brianthornock/Percussor/README.md

# Percussor
A Digitally-Controlled Analog Kick Drum Machine
