brianthornock/Percussor/Percussor_FullSchematic.png

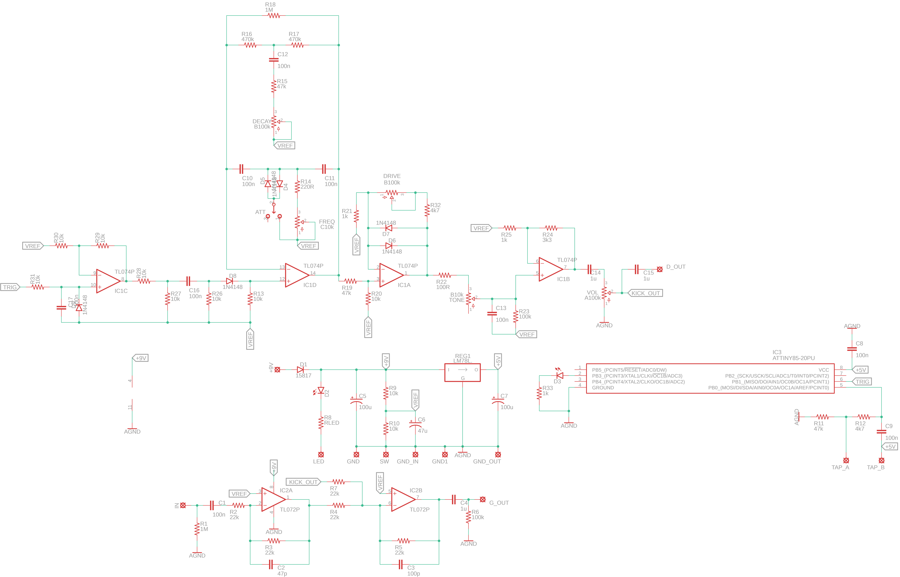
Percussor_FullSchematic.png
