brianthornock/Percussor/Percussor_Build_Documentation.pdf

# Percussor

## Digitally Controlled Analog Kick Drum with Tap Tempo

Provided to the DIY community for non-commercial use by Brian Thornock, copyright 2023

Overview

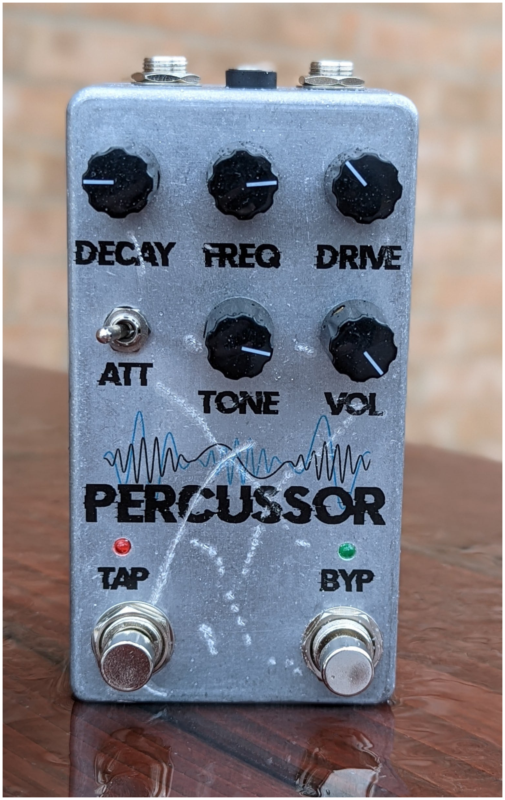
[picture p2: figure]

Have you ever seen one of those one man band performers with the bass drum on their back? It's kind of cool with how the bass drum helps keep the beat and can really flesh out a solo performance. If you have something that will do it for you, it also helps keep time and sounds way cooler than a boring metronome click. So I started looking around at analog kick drum circuits and found one that had some great sound shaping capability and decided I had to make a tap tempo kick drum pedal.

How it Works

The concept for the Percussor pretty straightforward. It has three main parts: guitar audio path, trigger generation, and the kick drum circuit. The guitar audio path allows for the kick drum sound to be mixed in with the guitar signal so that you can send it all to an amplifier and play it together. It also has the ability to send the kick drum signal out on it's own, acting as a standalone kick drum generator if you want to send it to its own channel or something like that. As you can see below, the guitar audio path is simply an inverting input buffer and a summing amplifier, so that overall the output is in phase with the input.

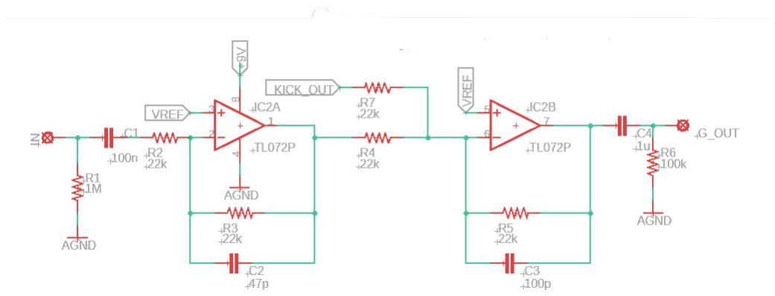
[picture p3: figure]

Percussor Guitar Audio Path

The kick drum circuit actually isn't mine, I found it third hand on a blog post linked on my website. It's a pretty clever design and only uses a single TL074 quad opamp package to provide controls for frequency, decay, drive, and tone, along with a two position attach switch. I did need to convert it to single supply voltage and I made a few small adjustments to taste, but it's certainly not an original design on my part.

The first opamp is used for conditioning the input pulse so that it will work well with the following stage.

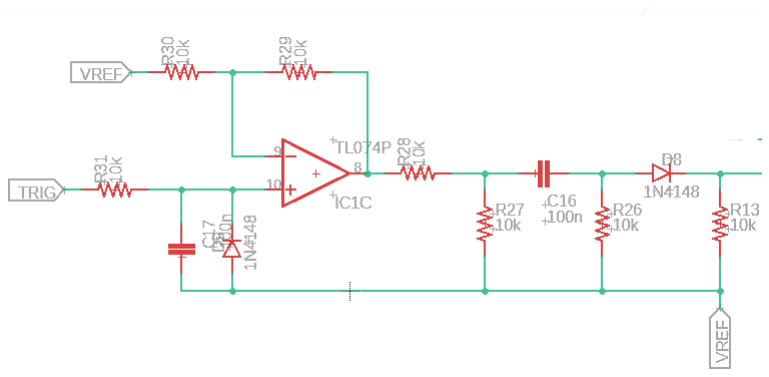
[picture p4: figure]

Percussor Pulse Conditioning Stage

The second opamp stage is a twin T filter where the actual kick drum sound is created from the pulse by filtering the trigger. Changing the two different filters allows for changing the frequency and decay of the kick drum sound, while the attack switch allows for a faster and slower setting.

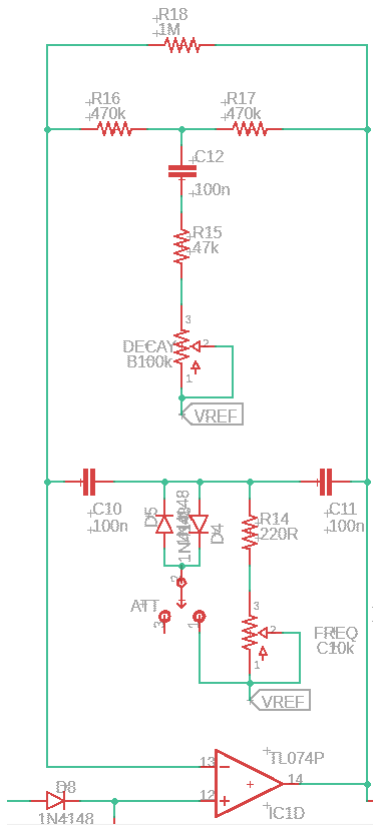
[picture p5: figure]

Percussor Twin T Filter

The third stage is a simple soft clipping opamp stage to add some drive/grit to the kick drum sound. While the clean kick drum sound is great, sometimes you want something that is a little more modern or edgy, and the drive can do that.

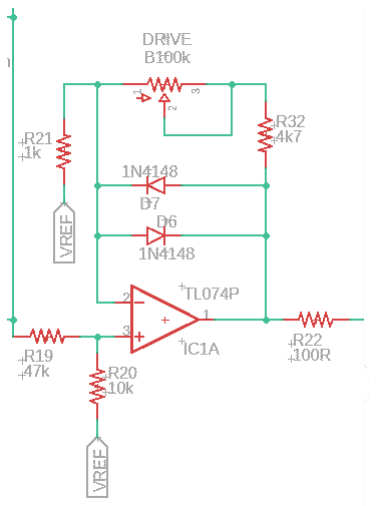
[picture p6: figure]

Percussor Drive Section

The final stage is a tone control, buffer, and volume control. The tone control is useful for rolling off some high end if you have a very bright amplifier or lots of drive on the kick drum sound. The buffer adds a little gain and allows for driving the volume control well, and the volume control allows you to adjust the output level so that it sits just right with the guitar.

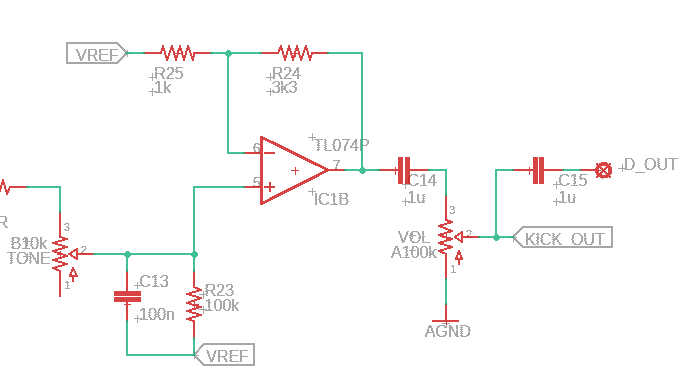
[picture p7: figure]

Percussor Tone Section

While the kick drum circuitry is cool and all, it doesn't do anything without a trigger pulse repeated regularly to create the pattern. To do this, I used a microcontroller to produce 2 ms wide pulses according to a tapped in tempo. This allows you to tap in the tempo you want and then the drum will repeat during that period indefinitely. Additionally, I put in some press and hold code for the tap tempo switch so that it also has a manual mode where the kick drum will only sound when you tap the TAP footswitch, making it function like a higher tech foot stomp pedal. I did have the though that, with all the unused pins, I should allow for different patterns, or put in a snare drum circuit, too, but I decided that those were outside the original scope and could be added later.

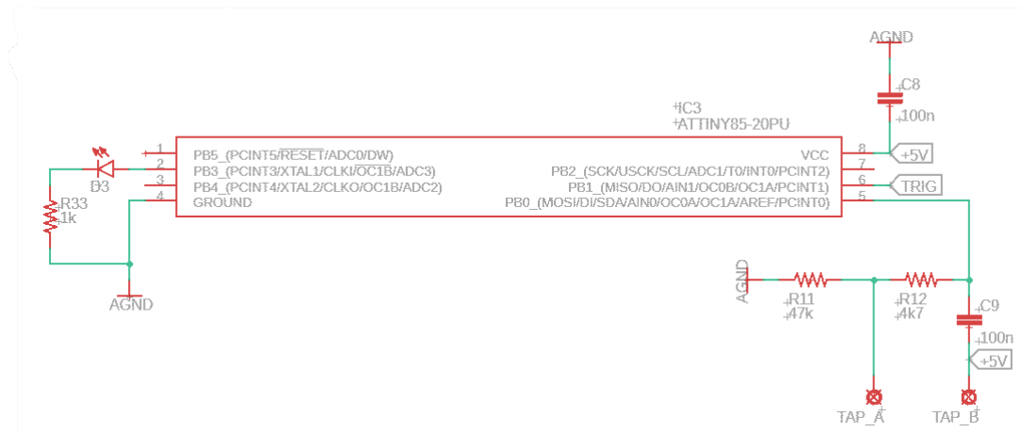
[picture p8: figure]

Percussor Digital Section

The power section for the percussor is the same as many of my digital/analog hybrid circuits. Not much to say about it.

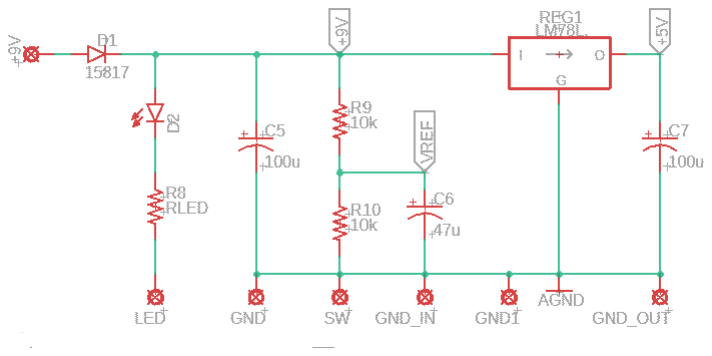
[picture p9: figure]

Percussor Power Section

BOM

The BOM below is the list of parts I used for mine along with quantities. All parts are through hole with resistors being 1/4W. I got everything from Tayda.

Part | Qty. | Notes
100R Resistor | 1
220R Resistor | 1
1k Resistor | 3
3k3 Resistor | 1
4k7 Resistor | 2
10k Resistor | 10
22k Resistor | 5
47k Resistor | 3
100k Resistor | 2
470k Resistor | 2
1M Resistor | 2
Current Limiting Resistor | 2
47pF Capacitor | 1
100pF Capacitor | 1
100nF Capacitor | 9
1uF Ceramic/Film Capacitor | 3
47uF Electrolytic Capacitor | 1
100uF Electrolytic Capacitor | 2
A100k Potentiometer | 1 | 16mm PCB Mount
B10k Potentiometer | 1 | 16mm PCB Mount
B100k Potentiometer | 2 | 16mm PCB Mount
C10k Potentiometer | 1 | 16mm PCB Mount
SPDT Toggle Switch | 1
1N5817 | 1
1N4148 | 6
LED | 2
78L05 | 1
TL072 | 1
TL074 | 1

ATTiny85 | 1 | ATTiny45 will also work
Enclosure | 1
1/4” input jack | 2
DC power jack | 1
3PDT footswitch | 1
SPST Momentary footswitch | 1 | Tap switch

Schematic

The schematic for this project is a little big to be legible on a single sheet, so it is included as a separate image in the project documentation folder.

Build Notes

Here are some things I noted from building the Percussor that might be helpful to you. Please read this section to make sure you don't go through excessive frustration.

Enclosure Size/Drilling

The Percussor fits nicely into a 125B. The board is a little too wide to fit a 1590B. Drilling for the footswitches should be done with some amount of care, as I ended up having to grind out one of the corner supports to fit in the switches. Moving them more towards the center would have saved me this heartache.

Jacks

Whatever jacks you use for in/out and power in 125B are fair game; no restrictions here.

Manual Mode

It is possible to do a manual mode where the Percussor behaves like a foot stomp box, meaning the pulse is only triggered when pressing the tap switch. I have some code that does this, but it makes tap tempo a little flaky, so I don't have this released at this moment

Ideas for Further Improvement

There are several unused pins on the ATTiny chip. I thought about setting up a manual time control, but opted not for this iteration. Additionally, a snare circuit could be added and triggered according to programmed patterns. These ideas are left as an exercise for the reader.

In Closing

While not a guitar effect itself, the Percussor can make your guitar playing a little more fun if playing by yourself.
